Srijal97/DC_Motor_Control/Drive_PCB_Altium/ver0/Project Outputs for PCB_DC_Motor_Drive/PCB_DC_Motor_Drive_BOM.xls

Designator | Value | Comment | Footprint | Quantity | Purchase | Buy Qty 5boards | Mouser Link
C1 | 100uF/25V | Electrolyte Cap | CAP 5MM | 1 | Local Market
C2, C4, C5, C6, C8, C10, C11, C15, C17, C19, C22, C24, C26, C28, C30, C31, C32, C33, C34, C36, C39, C40, C42, C43, C44, C45, C46, C47, C49 | 0.1uF | SMD 0805 10% | SMD0805 | 29 | Local Market
C3 | 220uF/25V | Electrolyte Cap | CAP_8mm | 1 | Local Market
C7 | 220uF/16V | Electrolyte Cap | CAP_8mm | 1 | Local Market
C9, C37, C48 | 10uF | SMD 0805 10% | SMD0805 | 3 | Local Market
C12, C13, C35, C38, C41 | 10nF | SMD 0805 10% | SMD0805 | 5 | Local Market
C14, C16, C18 | 470uF/35V | Electrolyte Cap | CAP 10MM DIA | 3 | Local Market
C20, C21 | 100uF/25V | 100uF/25V | CAP 5MM | 2 | Local Market
C23, C25 | 1uF | SMD 1206 10% | SMD1206 | 2 | Local Market
C27 | 22nF | SMD 0805 10% | SMD0805 | 1 | Local Market
C29 | 220pF | SMD 0805 10% | SMD0805 | 1 | Local Market
C50, C51 | 22pF | SMD 0805 10% | SMD0805 | 2 | Local Market
D1, D2, D3 | UF4007 | Diode SMA | DO-214(SMA) | 3 | Local Market
D4, D5, D6, D7, D10, D11, D12, D13, D14, D15 | 1N4148 | 1N4148 | SOD-80 | 10 | Local Market
D8, D9 | UF4007 | UF4007 | DO-214(SMA) | 2 | Local Market
FB1, FB2, FB3 | Bead Ferrite | Ferrite Bead | SMD0805 | 3 | Local Market
H1 | 2 pin Relimate Male Header | Header 2 pin | Header-2-Pin | 1 | Local Market
H2 | Header 3 pin | 10K_Pot | Header-3-Pin | 1 | Local Market
H3 | Header 2pin | Thermistor | Header-2-Pin | 1 | Local Market
H4 | 6 pin Header | PICkit3 | Header1x6 | 1 | Local Market
HS1, HS2, HS3, HS4, HS5 | Heatsink | Heatsink | Heatsink_25mm | 5 | Local Market
J1, J2, J3, J4, J5, J6, J7, J8 | Phonix 2 Pin | Phonix 2 Pin | PHONIX2 | 8 | Local Market
J9 | Phonix 3 Pin | Phonix 3 Pin | Phonix_3 | 1 | Local Market
LD1, LD2 | Red LED Through hole | LED | LED | 2 | Local Market
M1, M2 | SQJ457EP | P MOSFET | SO8-L | 2 | Mouser | 25 | https://www.mouser.in/ProductDetail/Vishay-Siliconix/SQJ457EP-T1_GE3
M3, M4, M5, M6, M7, M8 | PSMN013-60YL | N MOSFET | SO8-L | 6 | Mouser | 70 | https://www.mouser.in/ProductDetail/Nexperia/PSMN013-60YLX
P1 | 10K_Resistor_Pack | 10K_Resistor_Pack | HDR1X9 | 1 | Local Market
P2 | Header 5X2 | Header 5X2 | HDR2X5 | 1 | Local Market
Q1 | 2N2222 | NPN Transistor | SOT23-3-Leads | 1 | Local Market
R1 | 47R/2W | Series Resistor | Axial_2W_Vert | 1 | Local Market
R2, R73 | 1K | SMD 1206 1% | SMD1206 | 2 | Local Market
R3, R4, R5, R11, R12 | 8.2K | SMD 1206 1% | SMD1206 | 5 | Local Market
R6, R7, R8, R10, R51, R52, R54, R57 | 51k | SMD 1206 1% | SMD1206 | 8 | Local Market
R9, R40, R43, R44, R58, R60 | 22k | SMD 1206 1% | SMD1206 | 6 | Local Market
R13, R35, R38 | 180K | SMD 1206 1% | SMD1206 | 3 | Local Market
R14, R31, R33, R36, R41, R64, R68 | 2.2K | SMD 1206 1% | SMD1206 | 7 | Local Market
R15, R16, R19, R20, R25, R26 | 4.7R | SMD 1206 1% | SMD1206 | 6 | Local Market
R17, R18, R27, R28, R29, R30, R32, R37, R42, R45, R46, R67 | 10k | SMD 1206 1% | SMD1206 | 12 | Local Market
R21, R22, R23, R24, R70, R71, R72 | 510R | SMD 1206 1% | SMD1206 | 7 | Local Market
R34 | 10mOhm | CRA2512 | SMD2512 | 1 | Mouser | 10 | https://www.mouser.in/ProductDetail/Bourns/CRA2512-FZ-R010ELF
R39 | 5.1K | SMD 1206 1% | SMD1206 | 1 | Local Market
R47, R69 | 3.3K | SMD 1206 1% | SMD1206 | 2 | Local Market
R48, R49, R50, R53, R56, R59 | 2.2K | SMD 0603 1% | SMD0603 | 6 | Local Market
R55 | 15K | SMD 1206 1% | SMD1206 | 1 | Local Market
R61 | 4.7K | SMD 1206 1% | SMD1206 | 1 | Local Market
R62, R63, R65, R66 | 60.4R | SMD 1206 1% | SMD1206 | 4 | Local Market
S1, S2 | DIP Switch | 2.54mm DIP-4 SMD | DIP8 | 2 | Local Market
U1 | LM317 | LM317 | TO220_Normal | 1 | Local Market
U2 | LM7805 | LM7805 | TO220_Normal | 1 | Local Market
U3 | LM1117-3.3V | 3.3V Regulator | SOT-223 | 1 | Local Market
U4, U7, U8 | AZ4580 | LM358 | SOIC-8 | 3 | Mouser | 25 | https://www.mouser.in/ProductDetail/Diodes-Incorporated/AZ4580MTR-G1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
U5, U6 | LM5109B | LM5109B | SOIC-8 | 2 | Mouser | 15 | https://www.mouser.in/ProductDetail/Texas-Instruments/LM5109BMAX-NOPB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
U9 | NCV7351D13R2G | CAN Transciver | SOIC-8 | 1 | Mouser | 10 | https://www.mouser.in/ProductDetail/ON-Semiconductor/NCV7351D13R2G
U10 | ISL83072EIBZA-T | MAX485 | SOIC-8 | 1 | Mouser | 10 | https://www.mouser.in/ProductDetail/Renesas-Intersil/ISL83072EIBZA-T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
U11 | dsPIC33EP64MC506 | DSP | Quad64 | 1 | Mouser | 10 | https://www.mouser.in/ProductDetail/Microchip-Technology/dsPIC33EP64MC506-I-PT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
Y1 | 7.3728MHz | 7.3728MHz | XTAL | 1 | Local Market
