Srijal97/DC_Motor_Control/Drive_PCB_Altium/ver0/Project Outputs for PCB_DC_Motor_Drive/DC_Motor_Controller.PDF

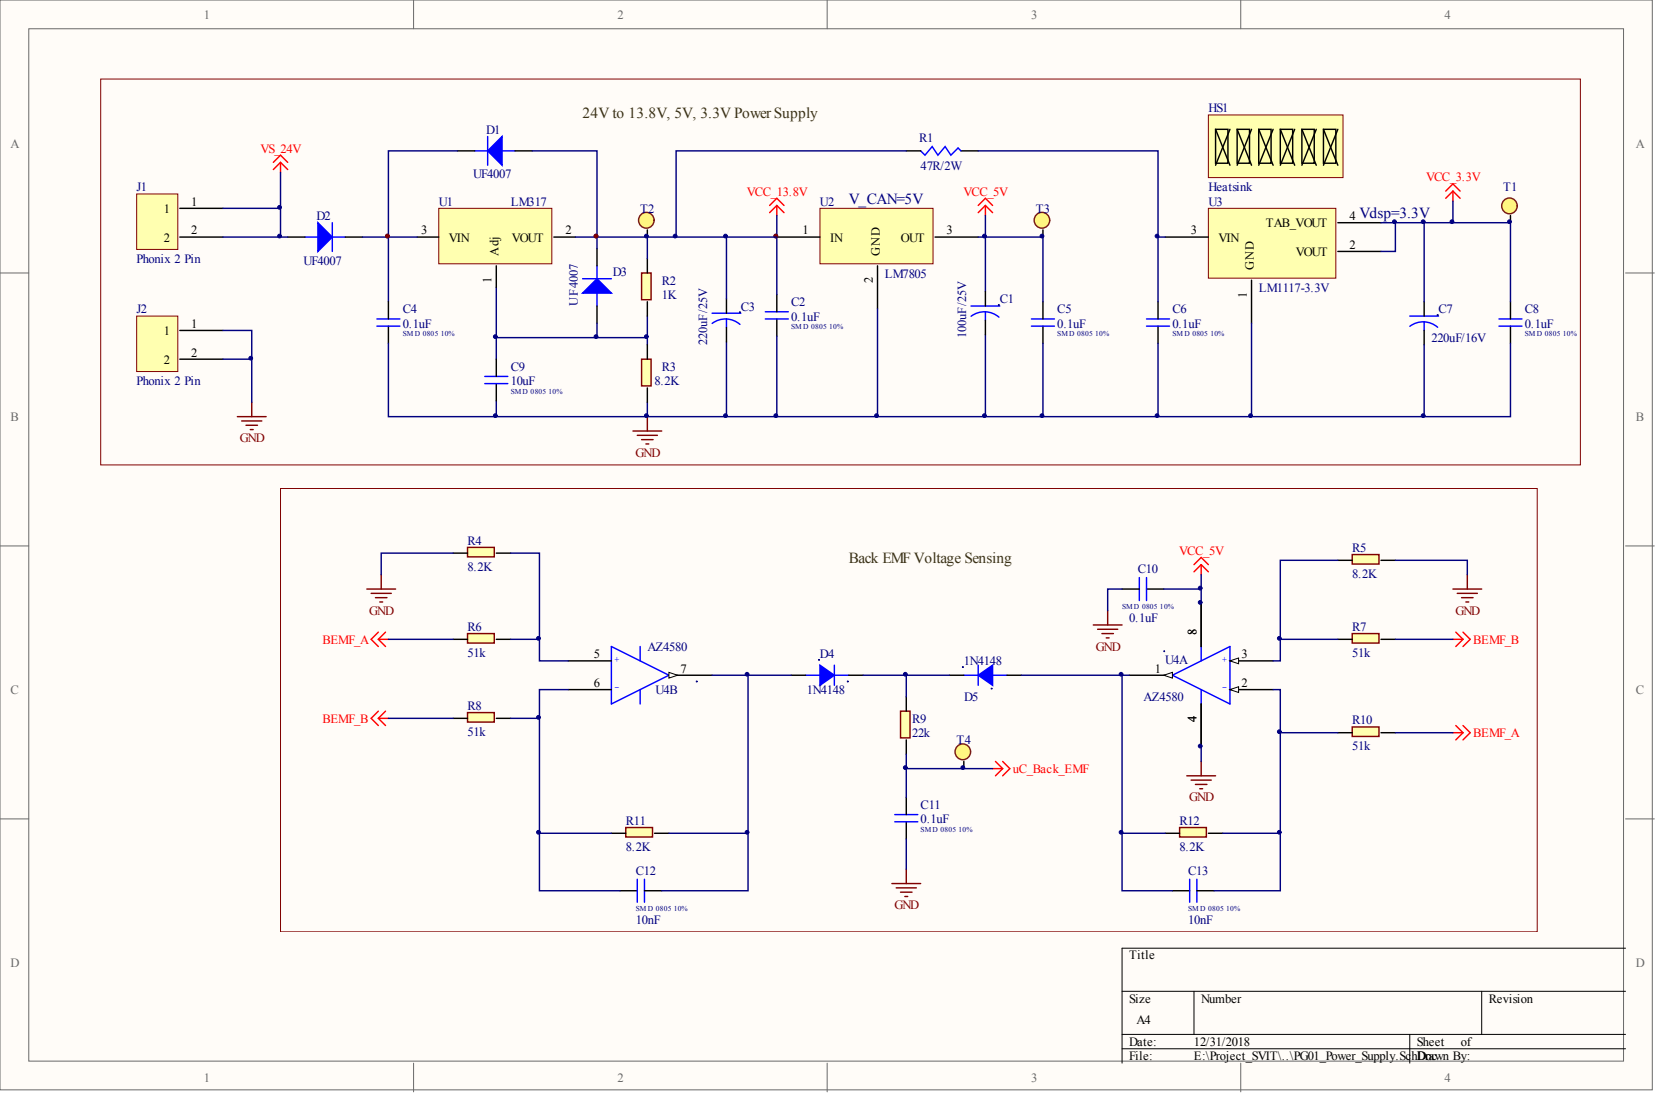
[picture p7: page 1]

Back EMF Voltage Sensing

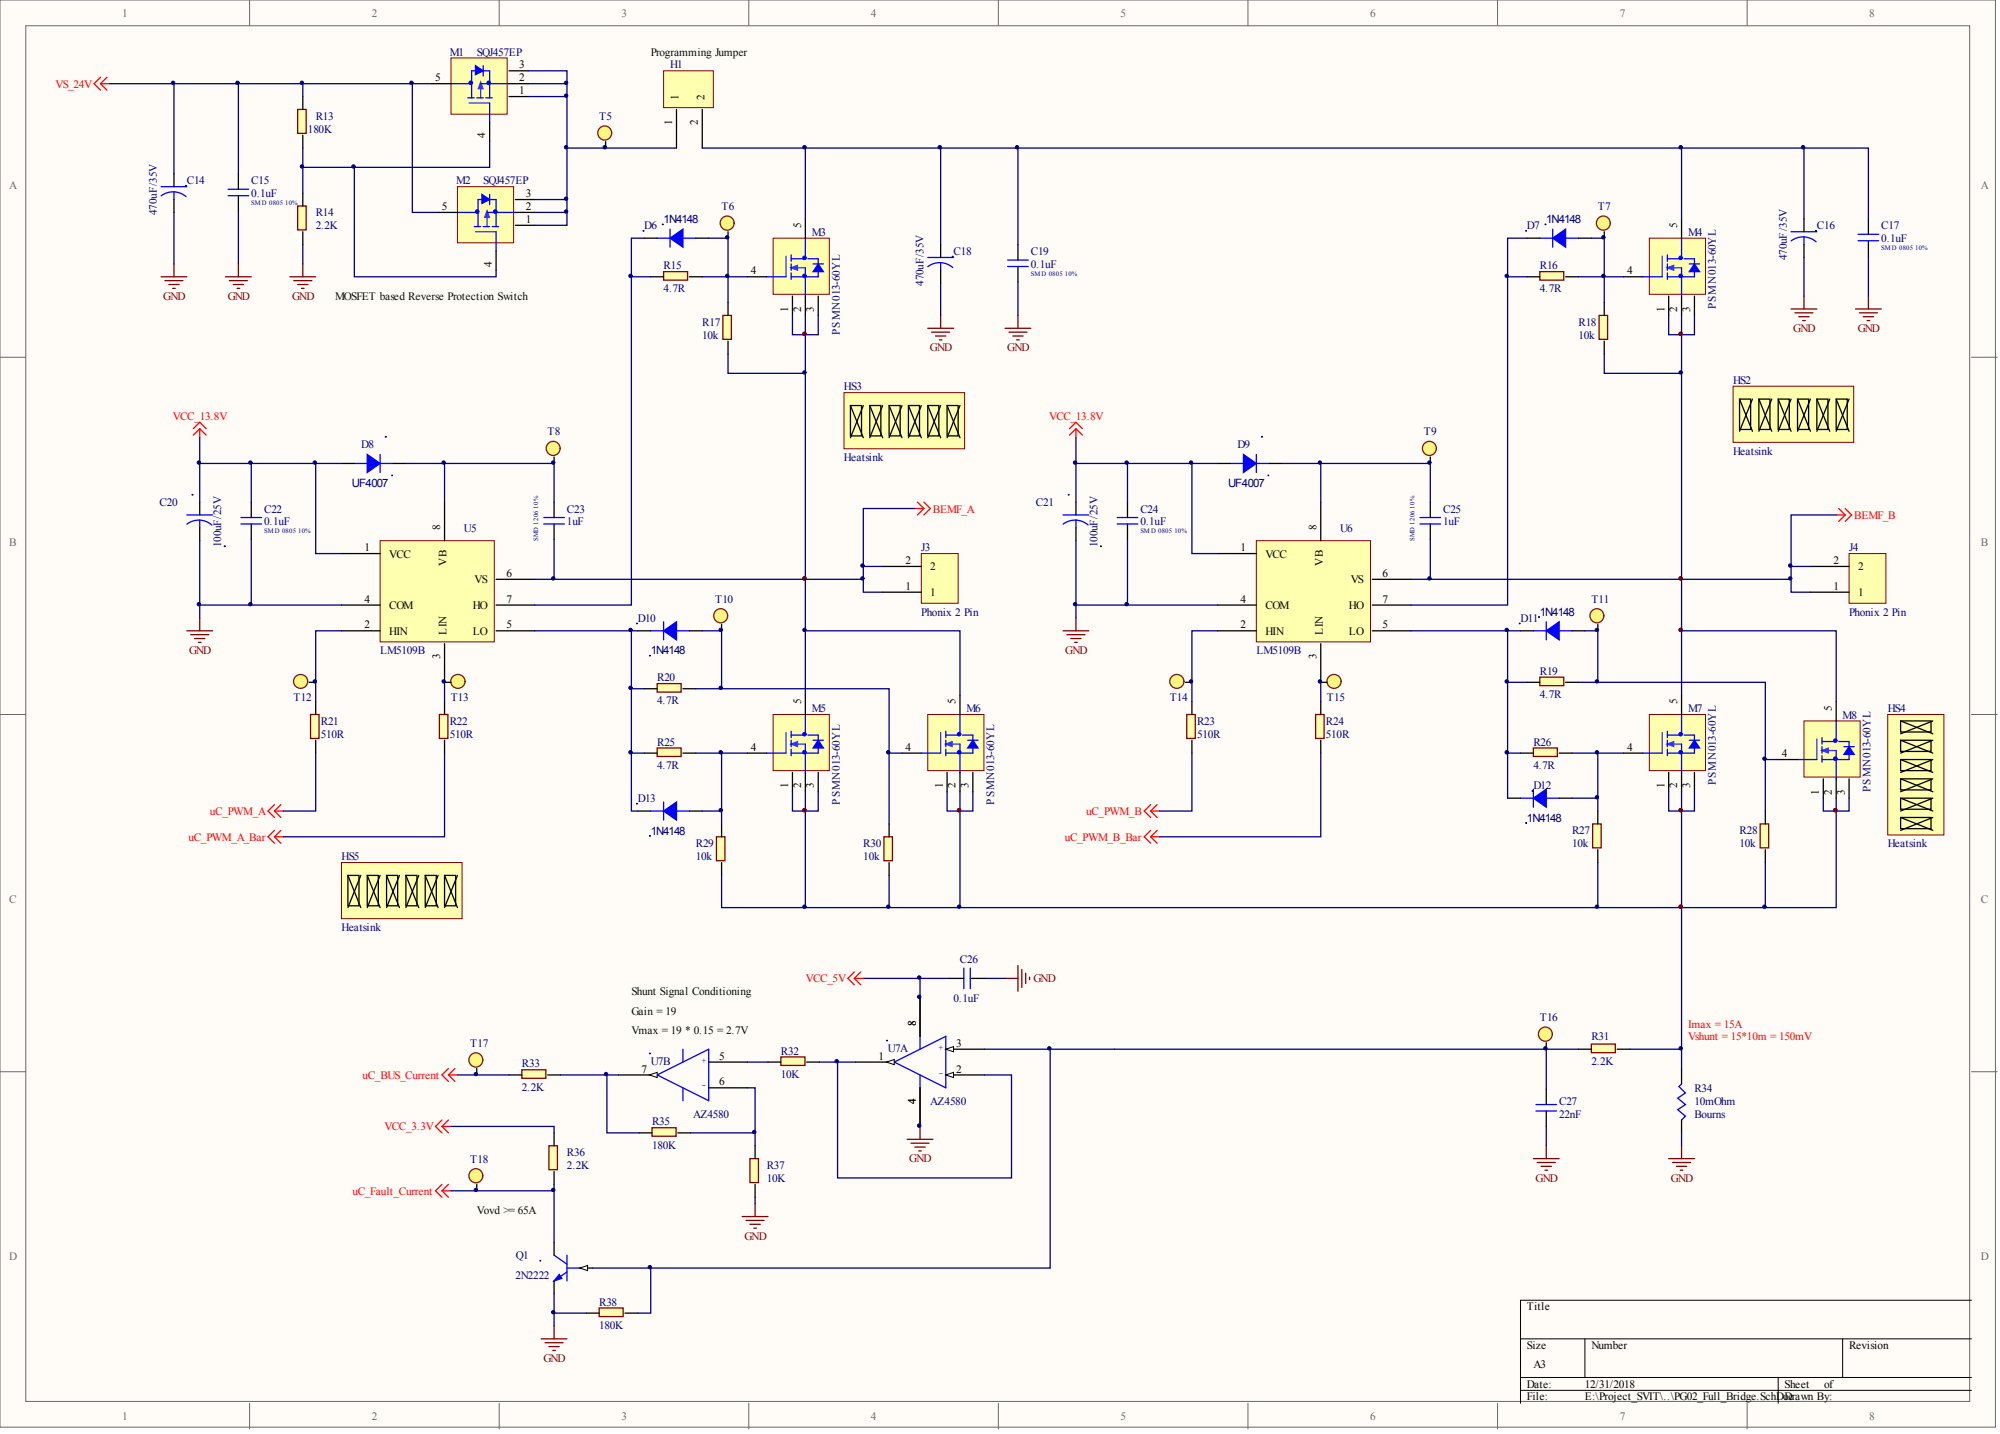
[picture p8: page 2]

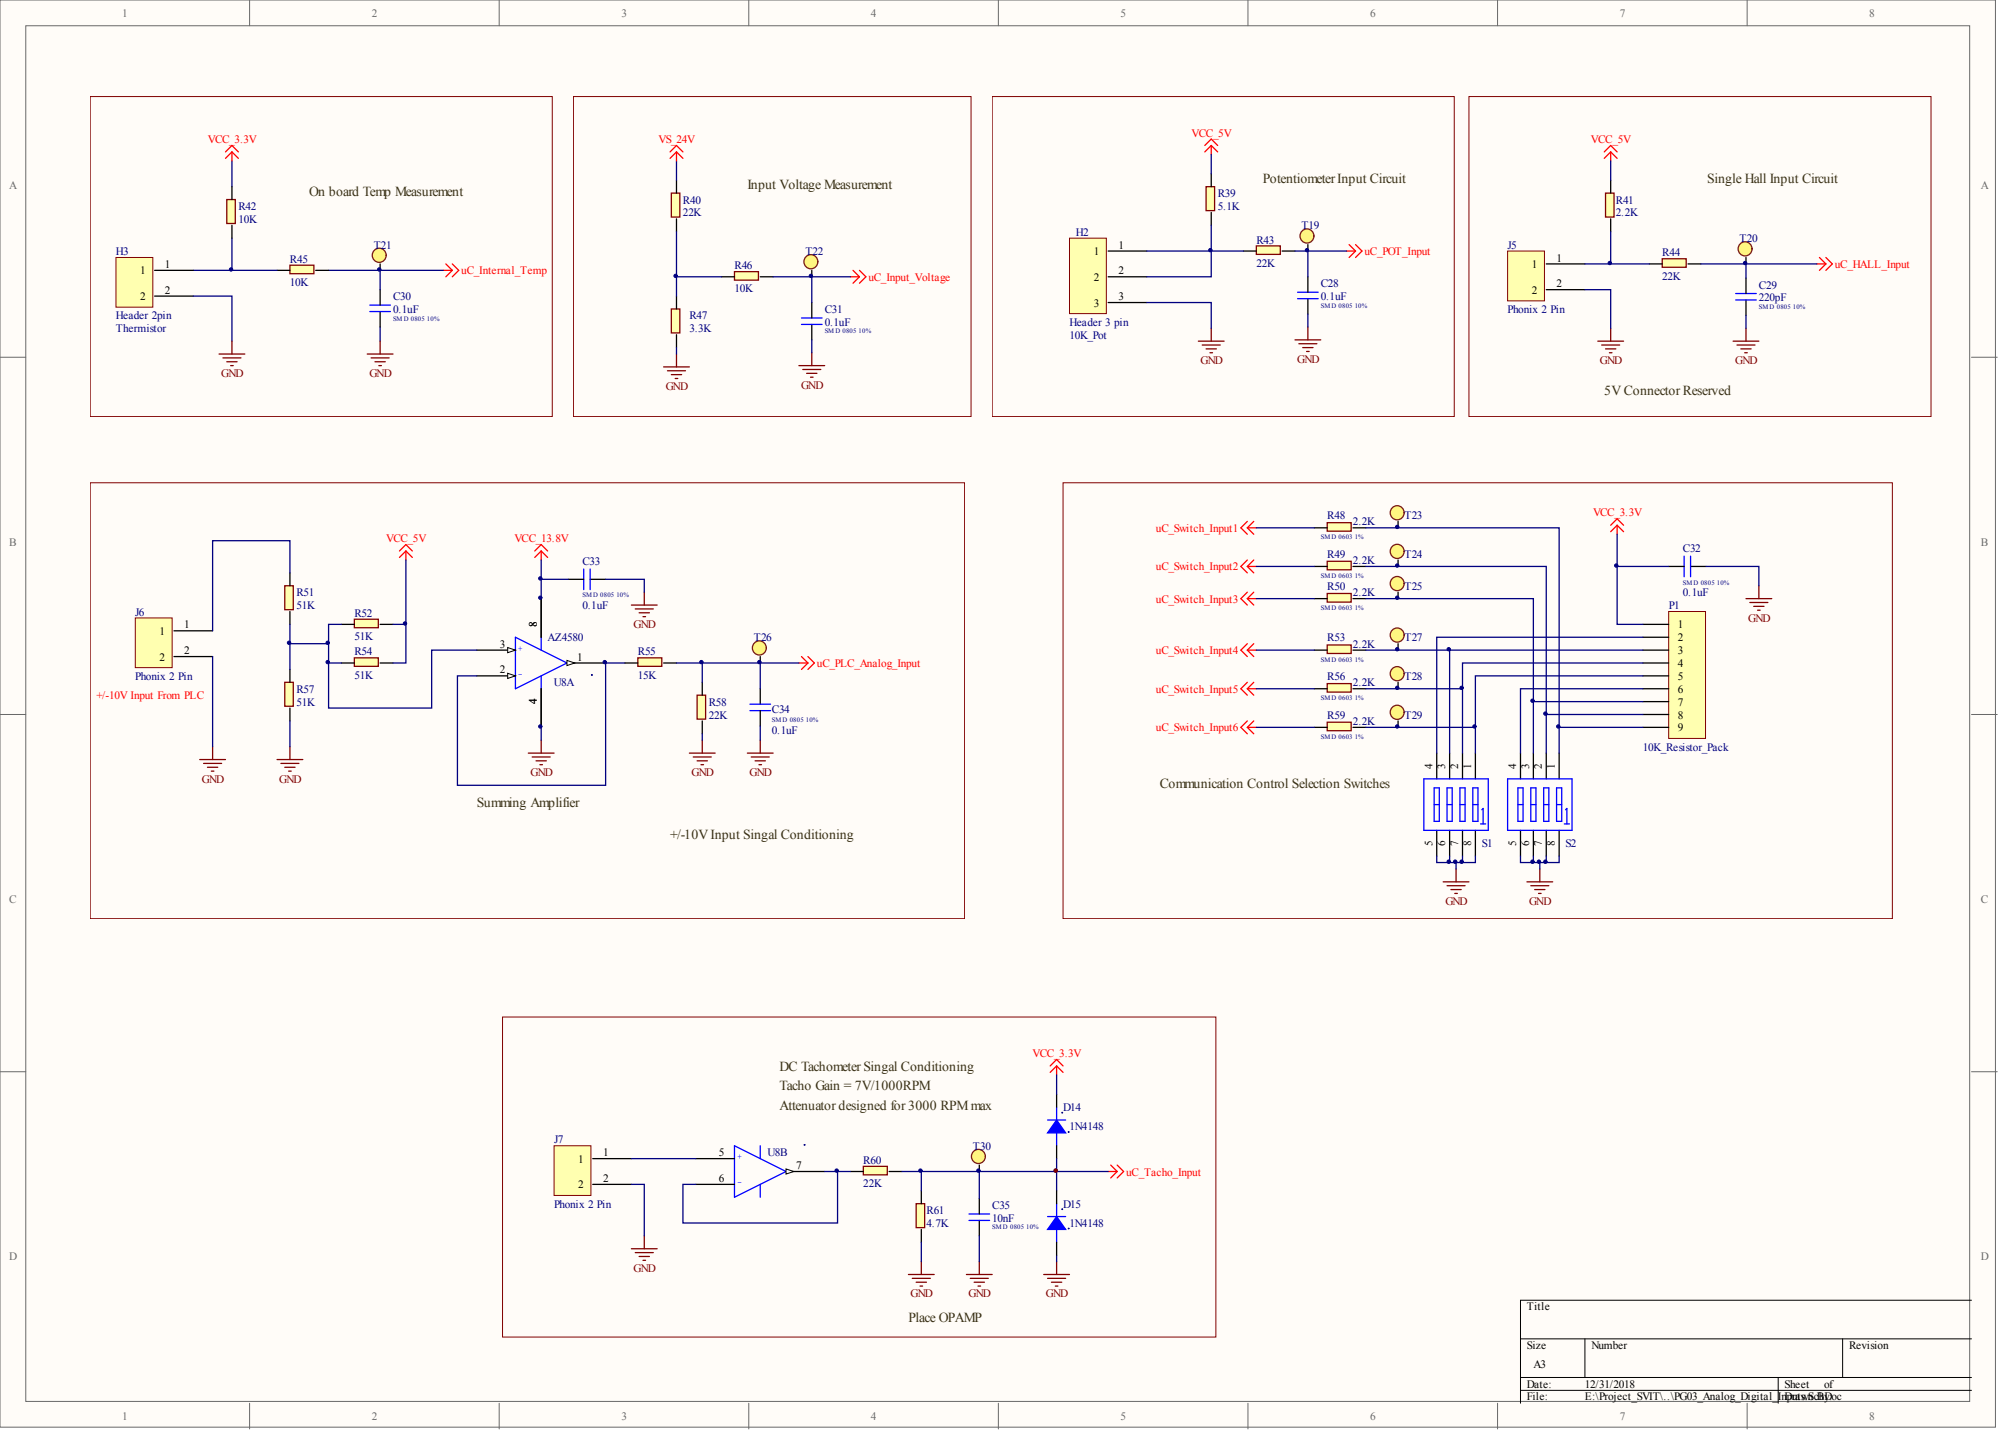
[picture p9: page 3]

Communication Control Selection Switches

DC Tachometer Singal Conditioning
Tacho Gain = 7V/1000RPM
Attenuator designed for 3000 RPM max

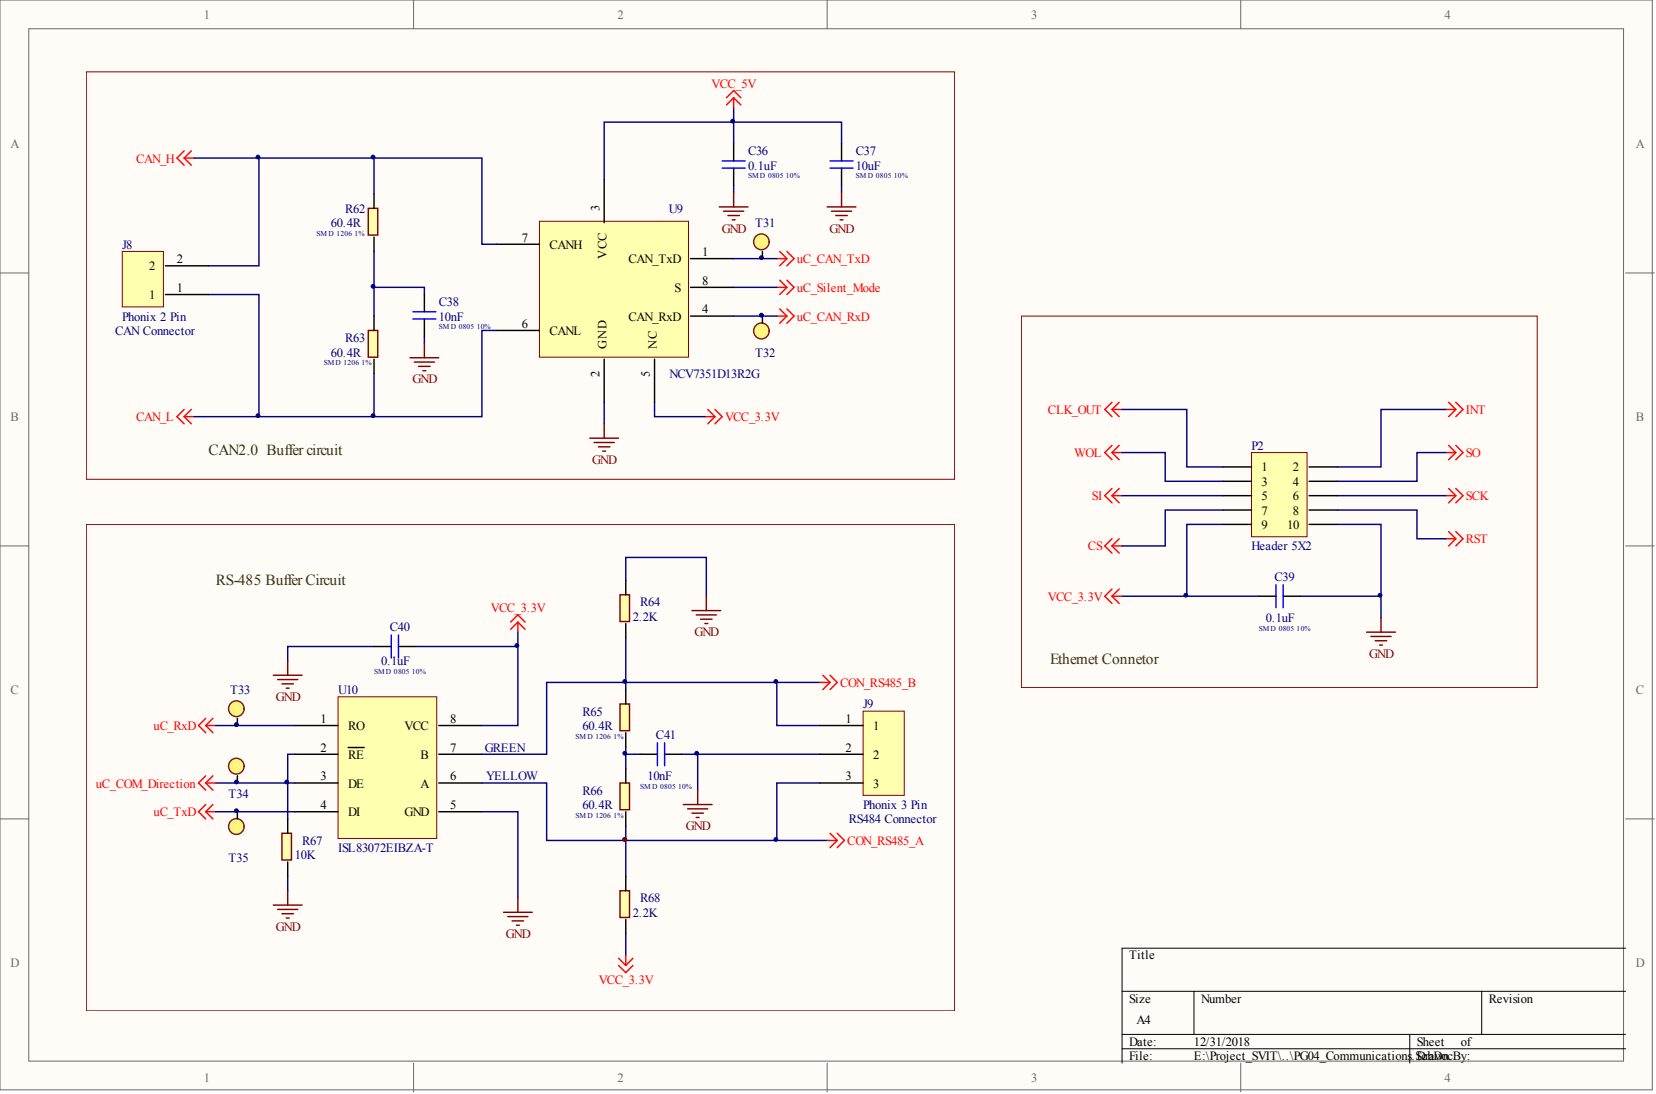
[picture p10: page 4]

DE 3 | YELLOW | 3 3

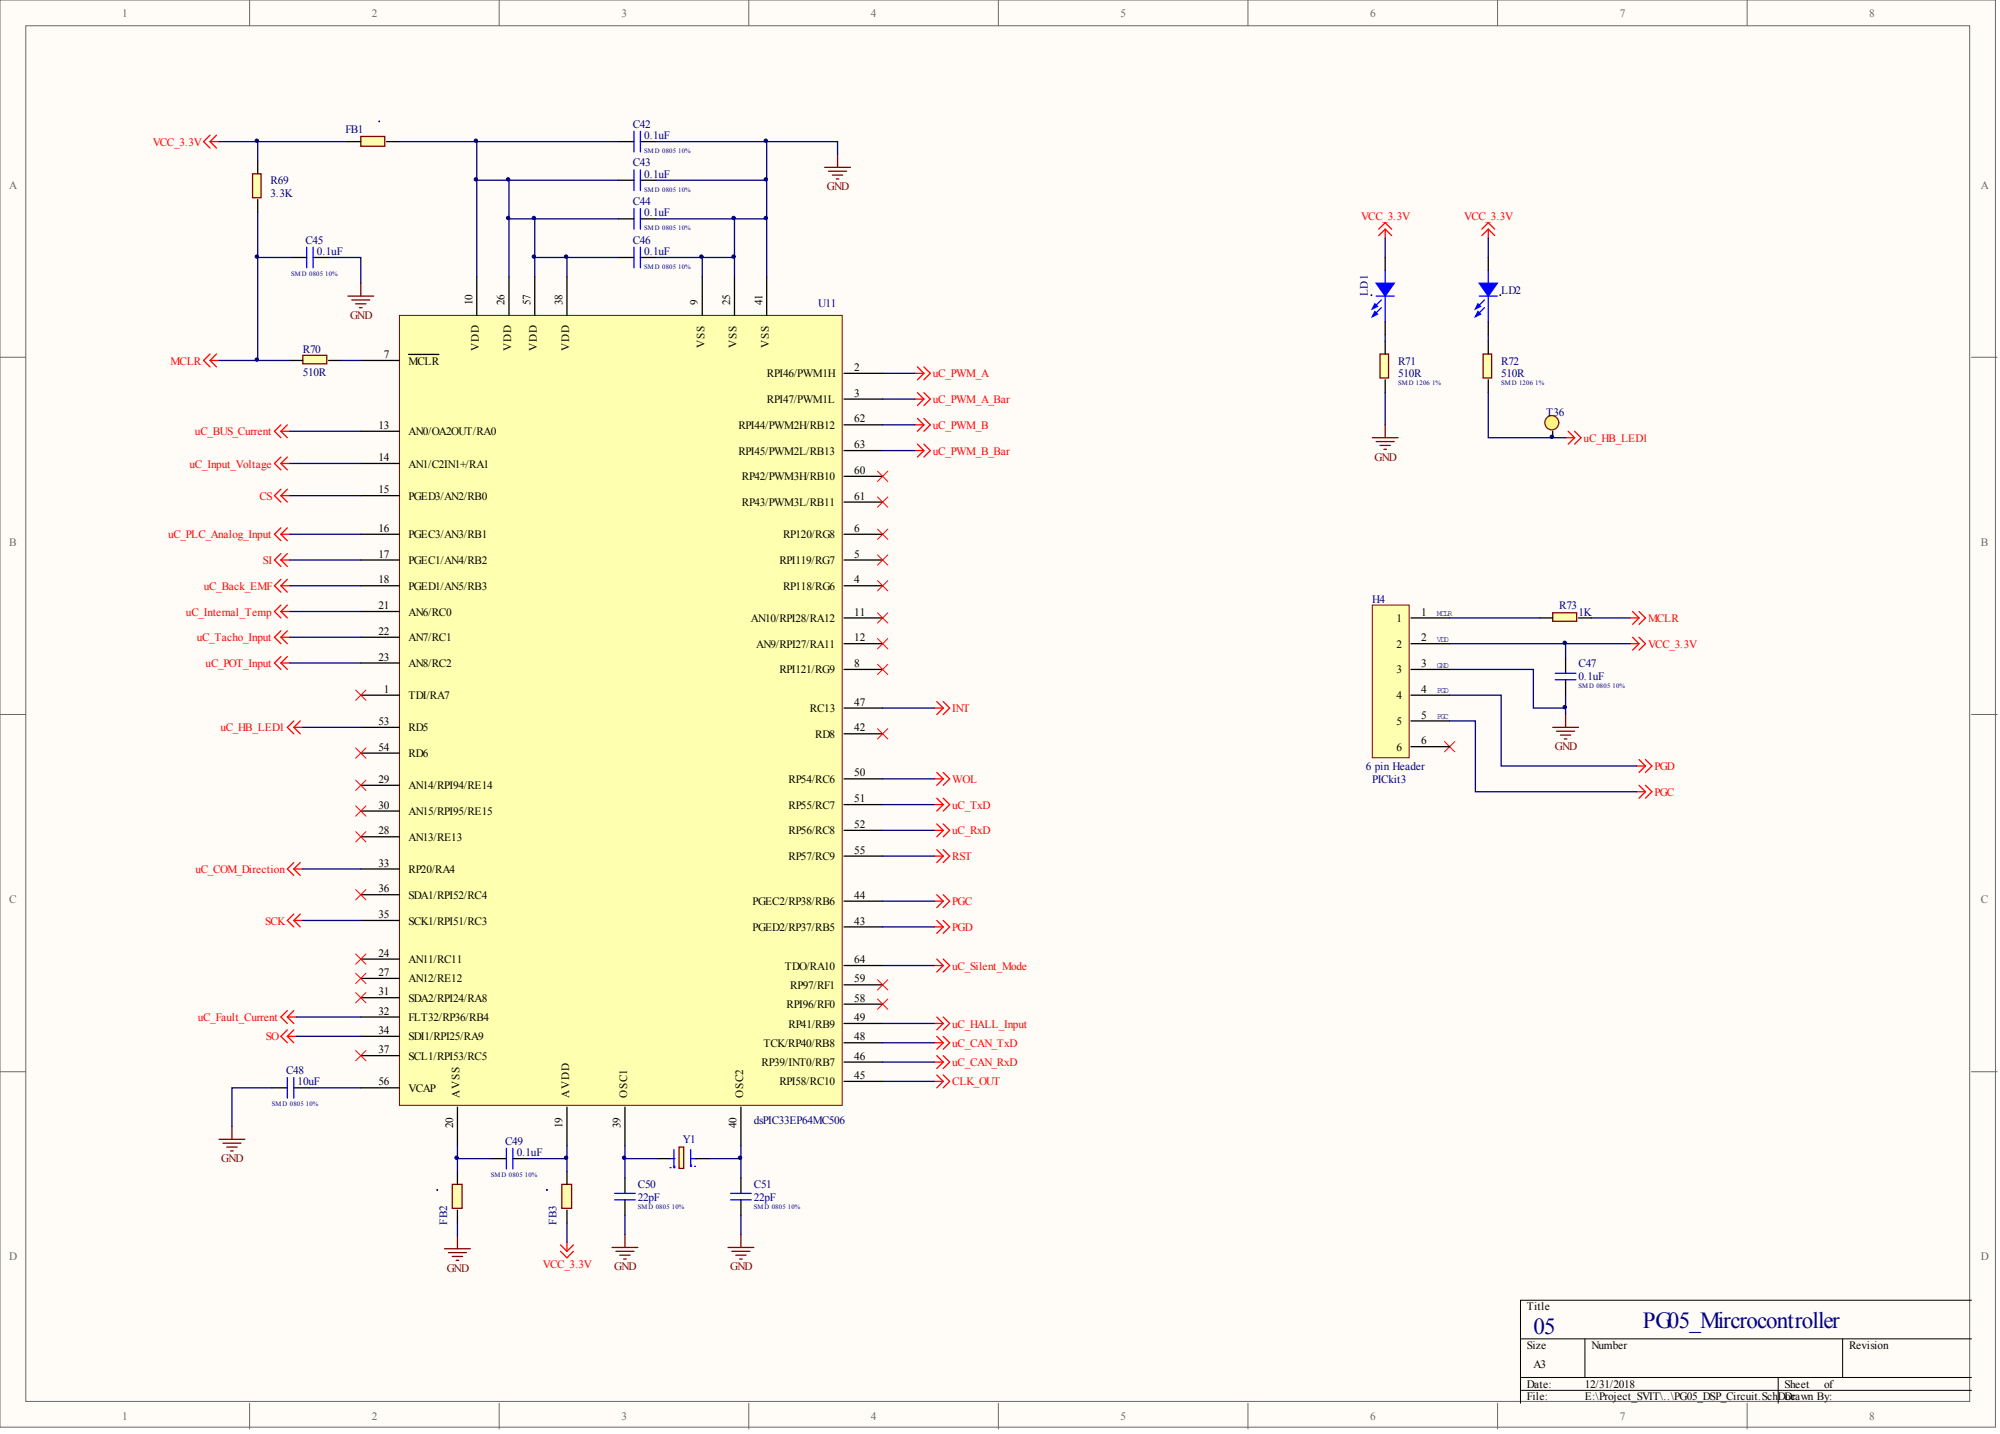
[picture p11: page 5]

GND PGC PGD VDD MCLR
