Srijal97/DC_Motor_Control/(list of files, drawings)

Other design files:
Drive_PCB_Altium/ver0/PCB_DC_Motor_Drive.PrjPCB
Drive_PCB_Altium/ver0/PCB_DCMotor.PcbDoc
Drive_PCB_Altium/ver0/PG01_Power_Supply.SchDoc
Drive_PCB_Altium/ver0/PG02_Full_Bridge.SchDoc
Drive_PCB_Altium/ver0/PG03_Analog_Digital_Inputs.SchDoc
Drive_PCB_Altium/ver0/PG04_Communications.SchDoc
Drive_PCB_Altium/ver0/PG05_DSP_Circuit.SchDoc
