Srijal97/DC_Motor_Control/DC_Motor_Controller.X/main.c

/**
  Generated main.c file from MPLAB Code Configurator

  @Company
    Microchip Technology Inc.

  @File Name
    main.c

  @Summary
    This is the generated main.c using PIC24 / dsPIC33 / PIC32MM MCUs.

  @Description
    This source file provides main entry point for system intialization and application code development.
    Generation Information :
        Product Revision  :  PIC24 / dsPIC33 / PIC32MM MCUs - 1.95-b-SNAPSHOT
        Device            :  dsPIC33EP64MC506
    The generated drivers are tested against the following:
        Compiler          :  XC16 v1.36
        MPLAB 	          :  MPLAB X v5.10
*/

/*
    (c) 2016 Microchip Technology Inc. and its subsidiaries. You may use this
    software and any derivatives exclusively with Microchip products.

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
    IN NO EVENT WILL MICROCHIP BE LIABLE FOR ANY INDIRECT, SPECIAL, PUNITIVE,
    INCIDENTAL OR CONSEQUENTIAL LOSS, DAMAGE, COST OR EXPENSE OF ANY KIND
    WHATSOEVER RELATED TO THE SOFTWARE, HOWEVER CAUSED, EVEN IF MICROCHIP HAS
    BEEN ADVISED OF THE POSSIBILITY OR THE DAMAGES ARE FORESEEABLE. TO THE
    FULLEST EXTENT ALLOWED BY LAW, MICROCHIP'S TOTAL LIABILITY ON ALL CLAIMS IN
    ANY WAY RELATED TO THIS SOFTWARE WILL NOT EXCEED THE AMOUNT OF FEES, IF ANY,
    THAT YOU HAVE PAID DIRECTLY TO MICROCHIP FOR THIS SOFTWARE.

    MICROCHIP PROVIDES THIS SOFTWARE CONDITIONALLY UPON YOUR ACCEPTANCE OF THESE
    TERMS.
*/

/**
  Section: Included Files
*/

// 70.0416 MHz Running
#include "mcc_generated_files/system.h"
#include "mcc_generated_files/pin_manager.h"
#include "mcc_generated_files/pwm.h"
#include "mcc_generated_files/tmr1.h"
#include "Macros.h"
#include "projMacros.h" 
#include "motorFun.h"
#include "globals.h"
#include "Tasks.h"
#include "BizLogic.h"
#include "CANProtocol.h"
#include "MODBUS.h"
#include "encoder.h"
#include "ISRs.h"


/*
                         Main application
 */


int main(void)
{
    // initialize the device
    SYSTEM_Initialize();
    QEI_initialize();
    PWM_ModuleEnable();
    
    PWM_DutyCycleSet(PWM_GENERATOR_1, 0);
    PWM_DutyCycleSet(PWM_GENERATOR_2, 0);
    
    createTableForMODBUS();
    
    IO_RA4_RS485_DIR_SetLow();
    
    TMR1_Start();   // Kernel Timer Start
    
    enableInterrupts();
    initInterrupts();
    
    if(IO_RG6_SW4_GetValue() == 0){  //If switch SW1 ON
        IO_RD5_HB_LED_SetLow();
        motorDirection = MOTOR_DIR_FORWARD;
    }
    else {
        IO_RD5_HB_LED_SetHigh();
        motorDirection = MOTOR_DIR_REVERSE;
    }
    
    motorControlMode = (IO_RG9_SW1_GetValue() << 2) 
                     + (IO_RA11_SW2_GetValue() << 1) 
                     + (IO_RA12_SW3_GetValue());

    while (1)
    {
        TMR1_Tasks_16BitOperation();    // 100uS Timer function

    }
    return 1; 
}


/**
 End of File
*/
