Srijal97/DC_Motor_Control/DC_Motor_Controller.X/myPID.h

/* 
 * File:   myPID.h
 * Author: YSRAO
 *
 * Created on July 18, 2019, 3:08 PM
 */

#ifndef MYPID_H
#define	MYPID_H

#ifdef	__cplusplus
extern "C" {
#endif




#ifdef	__cplusplus
}
#endif

#endif	/* MYPID_H */
