Srijal97/DC_Motor_Control/DC_Motor_Controller.X/Tasks.h

/* 
 * File:   Tasks.h
 * Author: Eshu
 *
 * Created on May 12, 2019, 1:03 PM
 */

#ifndef TASKS_H
#define	TASKS_H

#ifdef	__cplusplus
extern "C" {
#endif

#include "Macros.h"
#include "projMacros.h"
    
    
extern uINT eventRegister;
extern uINT ss_duty_count;

    
// Functions    
void TimerCallBack          (void); 

void Timer1msTask           (void);
void Timer10msTask          (void);
void Timer25msTask          (void);
void MODBUSDecodeTask       (void);     // Event Based Task
void CANBUSDecodeTask       (void);     // Event Based Task
void EthernetDecodeTask     (void);     // Event Based Task



#ifdef	__cplusplus
}
#endif

#endif	/* TASKS_H */
