Srijal97/DC_Motor_Control/DC_Motor_Controller.X/CANProtocol.c

//******************************************************************************
// Code developed for SVIT Mumbai
// This file includes all CAN communication functions
//******************************************************************************
#include "CANProtocol.h"
