Srijal97/DC_Motor_Control/DC_Motor_Controller.X/CANProtocol.h

/* 
 * File:   CANProtocol.h
 * Author: Eshu
 *
 * Created on May 12, 2019, 1:11 PM
 */

#ifndef CANPROTOCOL_H
#define	CANPROTOCOL_H

#ifdef	__cplusplus
extern "C" {
#endif

#include "Macros.h"
#include "projMacros.h"


#ifdef	__cplusplus
}
#endif

#endif	/* CANPROTOCOL_H */
