Srijal97/DC_Motor_Control/(commit log)

2019-07-03 Motor direction switching done. Create Repository
    [PCB_DCMotor.DRL, PCB_DCMotor.GBL, PCB_DCMotor.GBO, PCB_DCMotor.GBP, PCB_DCMotor.GBS, PCB_DCMotor.GKO, PCB_DCMotor.GM1, PCB_DCMotor.GTL]
2019-07-08 RPM with motor voltage relation with external Tacho calibration, changed PI controller
2019-07-19 changed PI, taken from Arduino PID library. Implemented with Karan. Duty cycle rolls over to 100 on crossing 55
2019-07-19 PID corrected by changing opamp vcc to 5V. PID tuned by checking encoder reference
    [BizLogic.c, globals.h, motorFun.c]
2019-07-29 Encoder RPM Control done. Does not work in reverse on startup.
    [BizLogic.c, encoder.c, encoder.h, main.c]
2019-09-10 Implemented torque control, discrete PID equations with switch for mode change
